CalgaryToSpace/CTS-SAT-2-Optical-Downlink-Module/README.md

# CTS-SAT-2-Optical-Downlink-Module
Repository for optical downlink module hardware and firmware development for the CTS-SAT-2 mission
