CalgaryToSpace/CTS-SAT-2-Optical-Downlink-Module/Transmitter/Hardware/FootprintLibrary/3D Model/MBRS320T3G.stp

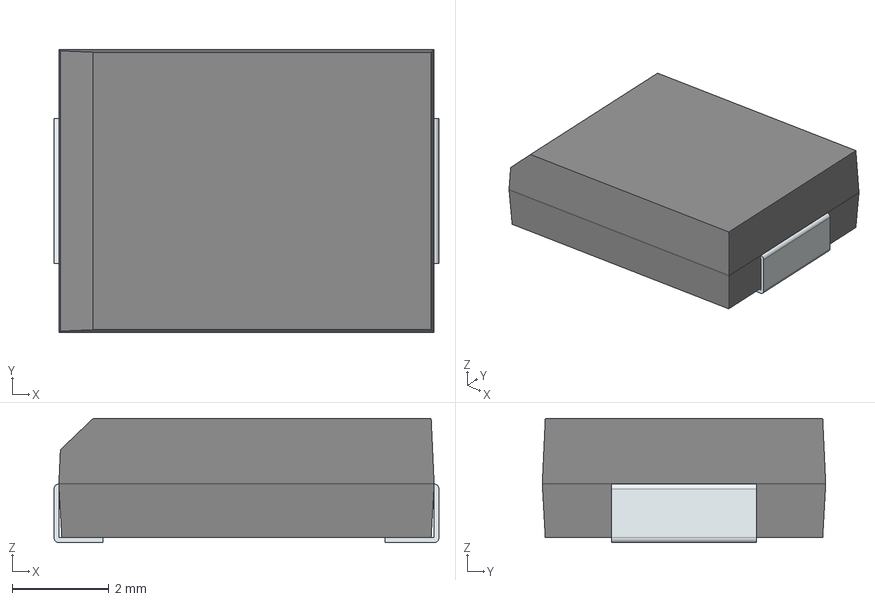
[picture p1: CAD file, 2026-05-02]
Transmitter/Hardware/FootprintLibrary/3D Model/MBRS320T3G.stp
7.94 x 5.84 x 2.56 mm
FilletPin1
FilletPin2
