CalgaryToSpace/CTS-SAT-2-Optical-Downlink-Module/Transmitter/Hardware/FootprintLibrary/3D Model/DR125.step

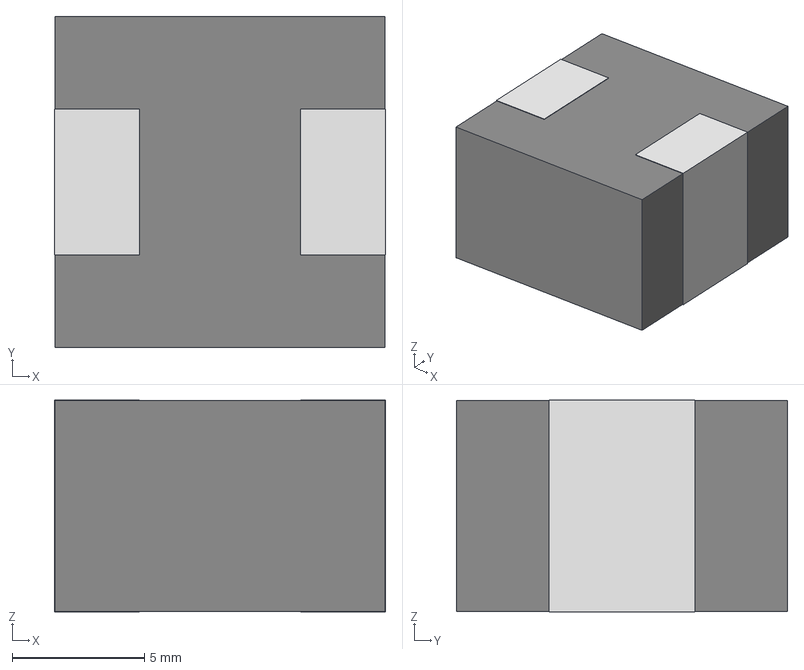
[picture p2: CAD file, 2026-02-14]
Transmitter/Hardware/FootprintLibrary/3D Model/DR125.step
12.5 x 12.5 x 8.00 mm
