CalgaryToSpace/CTS-SAT-2-Optical-Downlink-Module/Transmitter/Hardware/FootprintLibrary/3D Model/OD-624L.stp

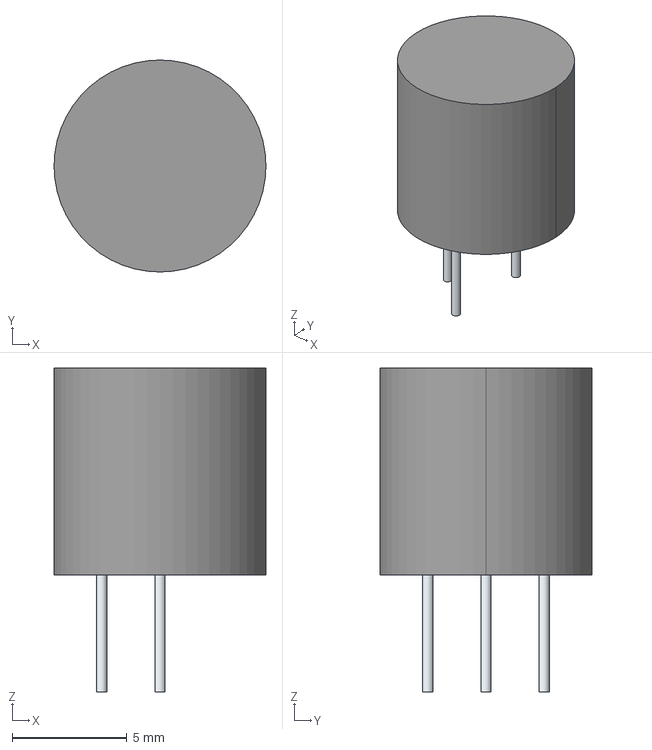
[picture p3: CAD file, 2026-02-11]
Transmitter/Hardware/FootprintLibrary/3D Model/OD-624L.stp
9.25 x 9.25 x 14.1 mm
Leads
