CalgaryToSpace/CTS-SAT-2-Optical-Downlink-Module/Transmitter/Hardware/OpticalDownlinkTransmitter.kicad_pcb

## KiCad design Transmitter/Hardware/OpticalDownlinkTransmitter.kicad_pcb (2026-05-02)

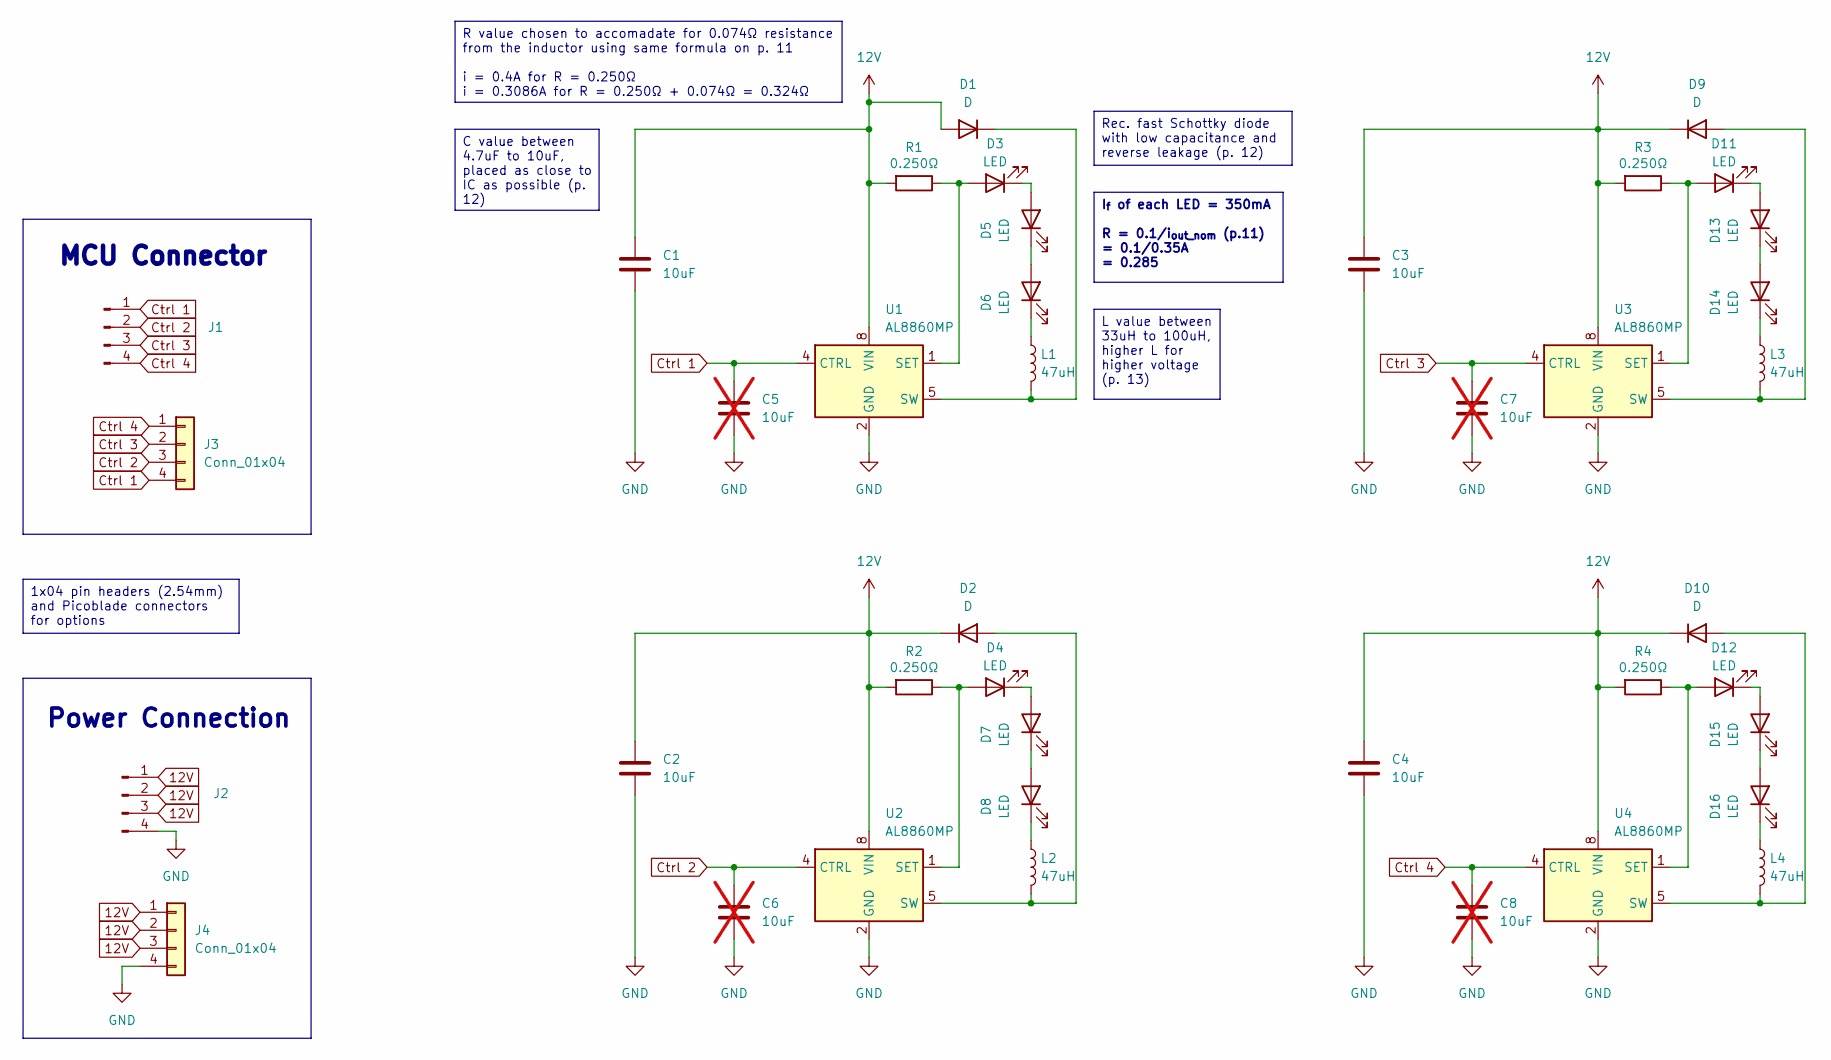
[picture p4: schematic OpticalDownlinkTransmitter.kicad_sch]

Parts:
C1, C2, C3, C4: 10uF; C_0805_2012Metric_Pad1.18x1.45mm_HandSolder; JLCPCB Part C95841
C5, C6, C7, C8: 10uF; C_0805_2012Metric_Pad1.18x1.45mm_HandSolder; JLCPCB Part C95841; not fitted
D1, D2, D9, D10: D; DIOM7958X256N; JLCPCB Part C236151
D3, D4, D5, D6, D7, D8, D11, D12, D13, D14, D15, D16: LED; OD624L; JLCPCB Part C20010764
J1, J2: Conn_01x04_Pin; PinSocket_1x04_P2.54mm_Vertical
J3, J4: Conn_01x04; CONN_532610001-SD_04_MOL
L1, L2, L3, L4: 47uH; DR125; JLCPCB Part C5120951
R1, R3, R4: 0.250Ω; R_2512_6332Metric_Pad1.40x3.35mm_HandSolder; JLCPCB Part C875877
R2: 0.250Ω; R_2512_6332Metric_Pad1.40x3.35mm_HandSolder; Digikey Part RLC73K2AR287FTD
U1, U2, U3, U4: AL8860MP; MSOP-8-1EP_3x3mm_P0.65mm_EP1.5x1.8mm; JLCPCB Part C500782

Connections:
12V: C1.1, C2.1, C3.1, C4.1, D1.2 (A), D2.1 (K), D9.1 (K), D10.1 (K), J2.1, J2.2, J2.3, J4.1, J4.2, J4.3, R1.2, R2.2, R3.2, R4.2, U1.8 (VIN), U2.8 (VIN), U3.8 (VIN), U4.8 (VIN)
Ctrl 1: C5.1, J1.1, J3.4, U1.4 (CTRL)
Ctrl 2: C6.1, J1.2, J3.3, U2.4 (CTRL)
Ctrl 3: C7.1, J1.3, J3.2, U3.4 (CTRL)
Ctrl 4: C8.1, J1.4, J3.1, U4.4 (CTRL)
GND: C1.2, C2.2, C3.2, C4.2, C5.2, C6.2, C7.2, C8.2, J2.4, J4.4, U1.2 (GND), U1.3 (GND), U1.9 (GND), U2.2 (GND), U2.3 (GND), U2.9 (GND), U3.2 (GND), U3.3 (GND), U3.9 (GND), U4.2 (GND), U4.3 (GND), U4.9 (GND)
unnamed: D1.1 (K), L1.2, U1.5 (SW), U1.6 (SW)
unnamed: D2.2 (A), L2.2, U2.5 (SW), U2.6 (SW)
unnamed: D3.2 (A), R1.1, U1.1 (SET)
unnamed: D3.1 (K), D5.2 (A)
unnamed: D4.2 (A), R2.1, U2.1 (SET)
unnamed: D4.1 (K), D7.2 (A)
unnamed: D5.1 (K), D6.2 (A)
unnamed: D6.1 (K), L1.1
unnamed: D7.1 (K), D8.2 (A)
unnamed: D8.1 (K), L2.1
unnamed: D9.2 (A), L3.2, U3.5 (SW), U3.6 (SW)
unnamed: D10.2 (A), L4.2, U4.5 (SW), U4.6 (SW)
unnamed: D11.2 (A), R3.1, U3.1 (SET)
unnamed: D11.1 (K), D13.2 (A)
unnamed: D12.2 (A), R4.1, U4.1 (SET)
unnamed: D12.1 (K), D15.2 (A)
unnamed: D13.1 (K), D14.2 (A)
unnamed: D14.1 (K), L3.1
unnamed: D15.1 (K), D16.2 (A)
unnamed: D16.1 (K), L4.1

Notes on the sheet:
MCU Connector
Power Connection
R value chosen to accomadate for 0.074Ω resistance from the inductor using same formula on p. 11 i = 0.4A for R = 0.250Ω i = 0.3086A for R = 0.250Ω + 0.074Ω = 0.324Ω
1x04 pin headers (2.54mm) and Picoblade connectors for options
I_{f} of each LED = 350mA R = 0.1/i_{out_nom} (p.11) = 0.1/0.35A = 0.285
Rec. fast Schottky diode with low capacitance and reverse leakage (p. 12)
L value between 33uH to 100uH, higher L for higher voltage (p. 13)
C value between 4.7uF to 10uF, placed as close to IC as possible (p. 12)

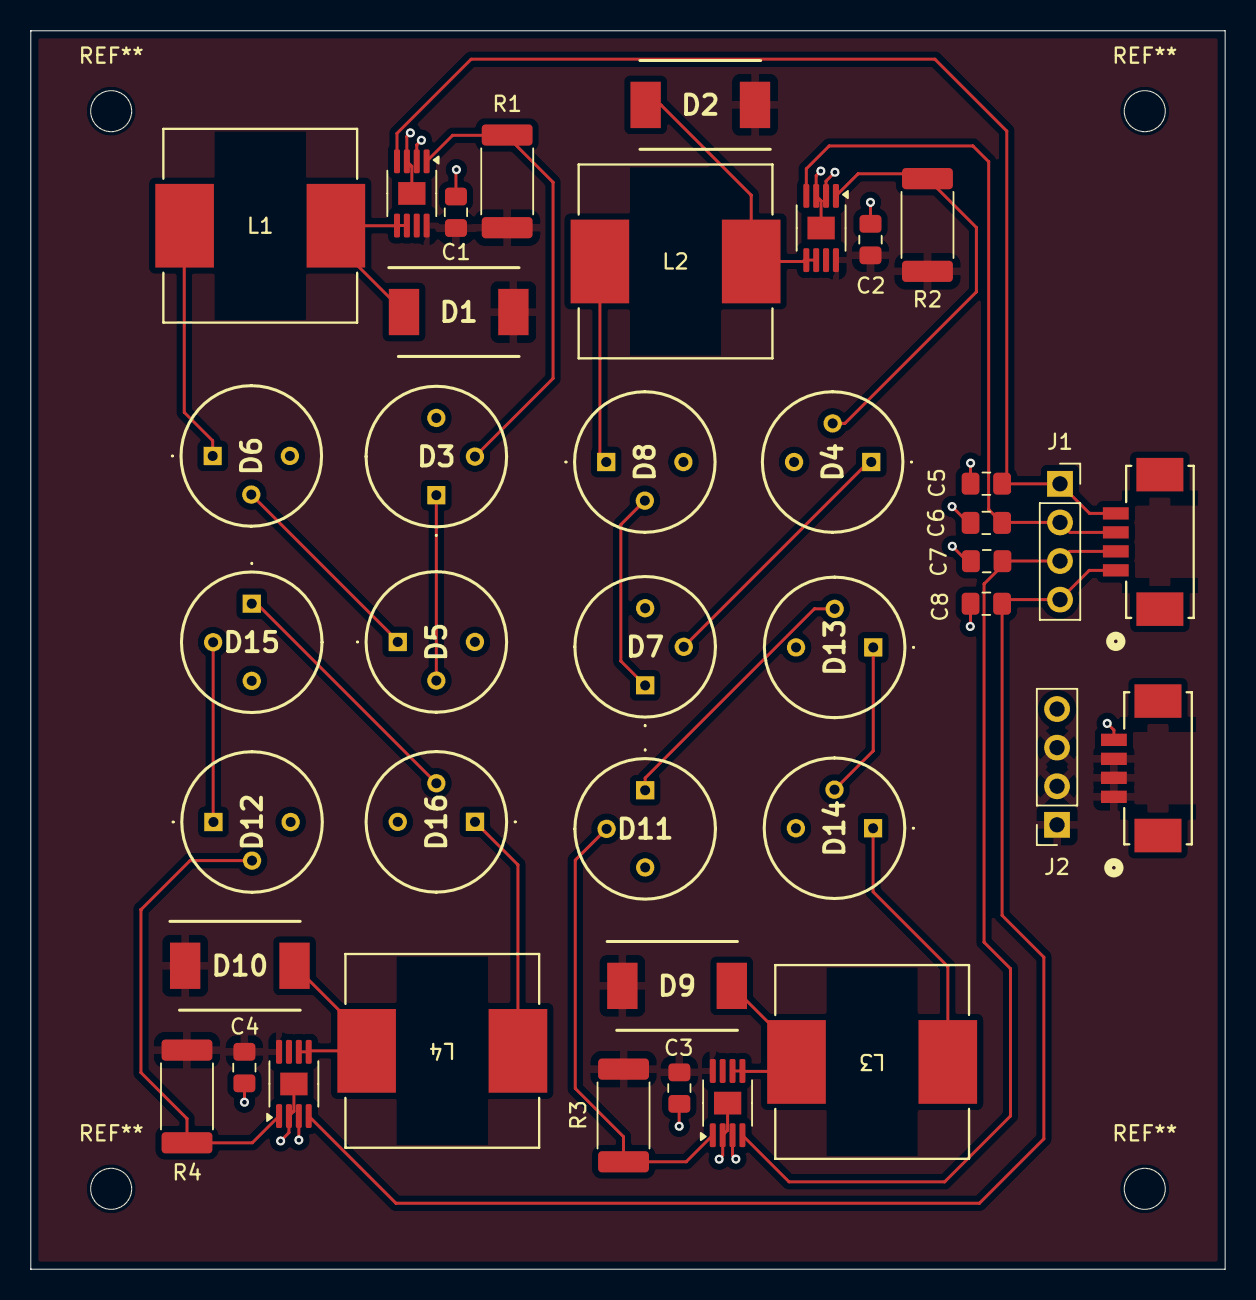
[picture p5: board OpticalDownlinkTransmitter.kicad_pcb from above]

Board: 2 copper layers, 78.6 x 81.5 mm, 40 parts (0 on the bottom side), 26 nets.
