CalgaryToSpace/CTS-SAT-2-Optical-Downlink-Module/Receiver/Hardware/Optical Downlink Kicad Project.kicad_pcb

## KiCad design Receiver/Hardware/Optical Downlink Kicad Project.kicad_pcb (2026-02-25)

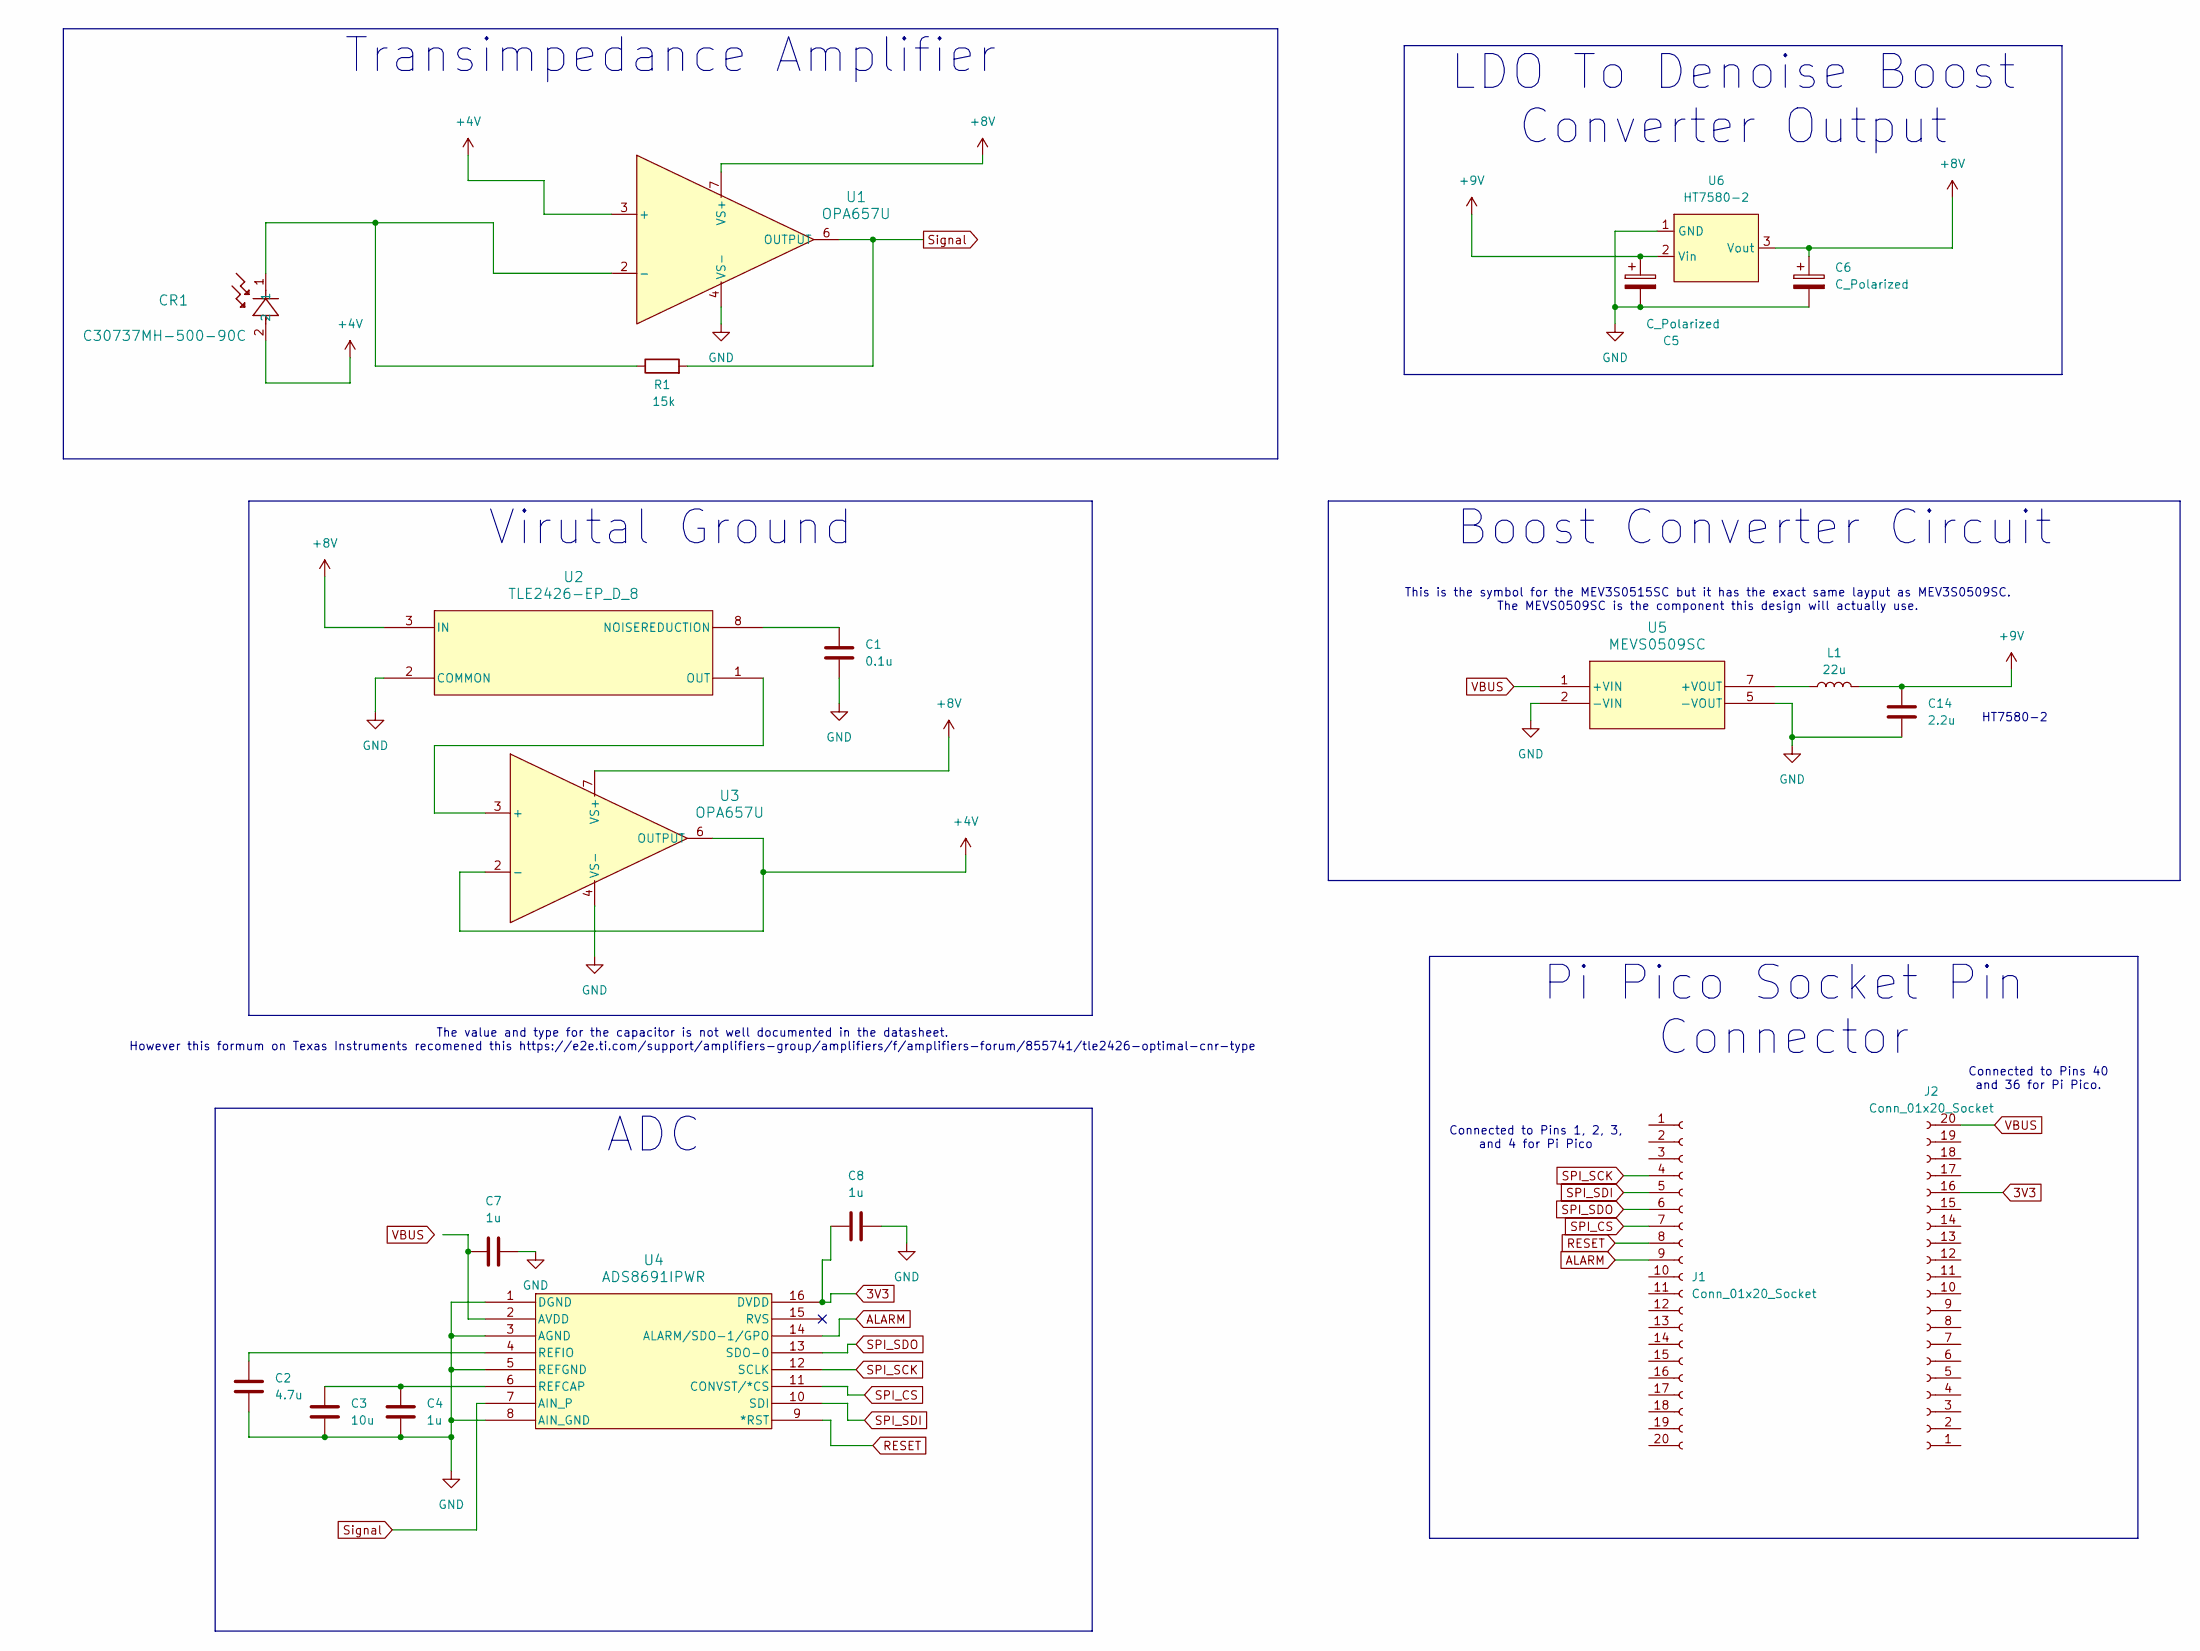
[picture p6: schematic Optical Downlink Kicad Project.kicad_sch]

Parts:
C1: 0.1u; CAPC1005X55N
C2: 4.7u; C_0603_1608Metric
C3: 10u; C_0402_1005Metric
C4, C7, C8: 1u; CAP_CL10_SAM
C5, C6: C_Polarized; CAPMP6.3X3.2_2.8N_KEM
C14: 2.2u; C_0603_1608Metric
CR1: C30737MH-500-90C; FR4_C30737MH_EXT
J1, J2: Conn_01x20_Socket; PinHeader_1x20_P2.54mm_Vertical
L1: 22u; IND_8400_84XXXC_MUR
R1: 15k; RC0402N_YAG
U1, U3: OPA657U; OPA 657 D8
U2: TLE2426-EP_D_8; D8_TEX TLE2426-EP_D_8
U4: ADS8691IPWR; ADS8691IPWR_TEX
U5: MEVS0509SC; DC_MEV3_7P65X19P65_MUR
U6: HT7580-2; SOT-23-5

Connections:
3V3: C8.1, J2.16, U4.16 (DVDD)
+4V: CR1.2, U1.3 (+), U3.2 (-), U3.6 (OUTPUT)
+8V: C6.1, U1.7 (VS+), U2.3 (IN), U3.7 (VS+), U6.3 (Vout)
+9V: C5.1, C14.1, L1.2, U6.2 (Vin)
ALARM: J1.9, U4.14 (ALARM/SDO-1/GPO)
GND: C1.2, C2.2, C3.2, C4.2, C5.2, C6.2, C7.2, C8.2, C14.2, U1.4 (VS-), U2.2 (COMMON), U3.4 (VS-), U4.1 (DGND), U4.3 (AGND), U4.5 (REFGND), U4.8 (AIN_GND), U5.2 (-VIN), U5.5 (-VOUT), U6.1 (GND)
unnamed: CR1.1, R1.1, U1.2 (-)
unnamed: C1.1, U2.8 (NOISEREDUCTION)
unnamed: U2.1 (OUT), U3.3 (+)
unnamed: C7.1, U4.2 (AVDD)
unnamed: C3.1, C4.1, U4.6 (REFCAP)
unnamed: C2.1, U4.4 (REFIO)
unnamed: L1.1, U5.7 (+VOUT)
RESET: J1.8, U4.9 (*RST)
SPI_CS: J1.7, U4.11 (CONVST/*CS)
SPI_SCK: J1.4, U4.12 (SCLK)
SPI_SDI: J1.5, U4.10 (SDI)
SPI_SDO: J1.6, U4.13 (SDO-0)
Signal: R1.2, U1.6 (OUTPUT), U4.7 (AIN_P)
VBUS: J2.20, U5.1 (+VIN)

Notes on the sheet:
Connected to Pins 1, 2, 3, and 4 for Pi Pico
The value and type for the capacitor is not well documented in the datasheet. However this formum on Texas Instruments recomened this https://e2e.ti.com/support/amplifiers-group/amplifiers/f/amplifiers-forum/855741/tle2426-optimal-cnr-type
Connected to Pins 40 and 36 for Pi Pico.
HT7580-2
This is the symbol for the MEV3S0515SC but it has the exact same layput as MEV3S0509SC. The MEVS0509SC is the component this design will actually use.
LDO To Denoise Boost Converter Output
Boost Converter Circuit
Pi Pico Socket Pin Connector
Virutal Ground
Transimpedance Amplifier
ADC

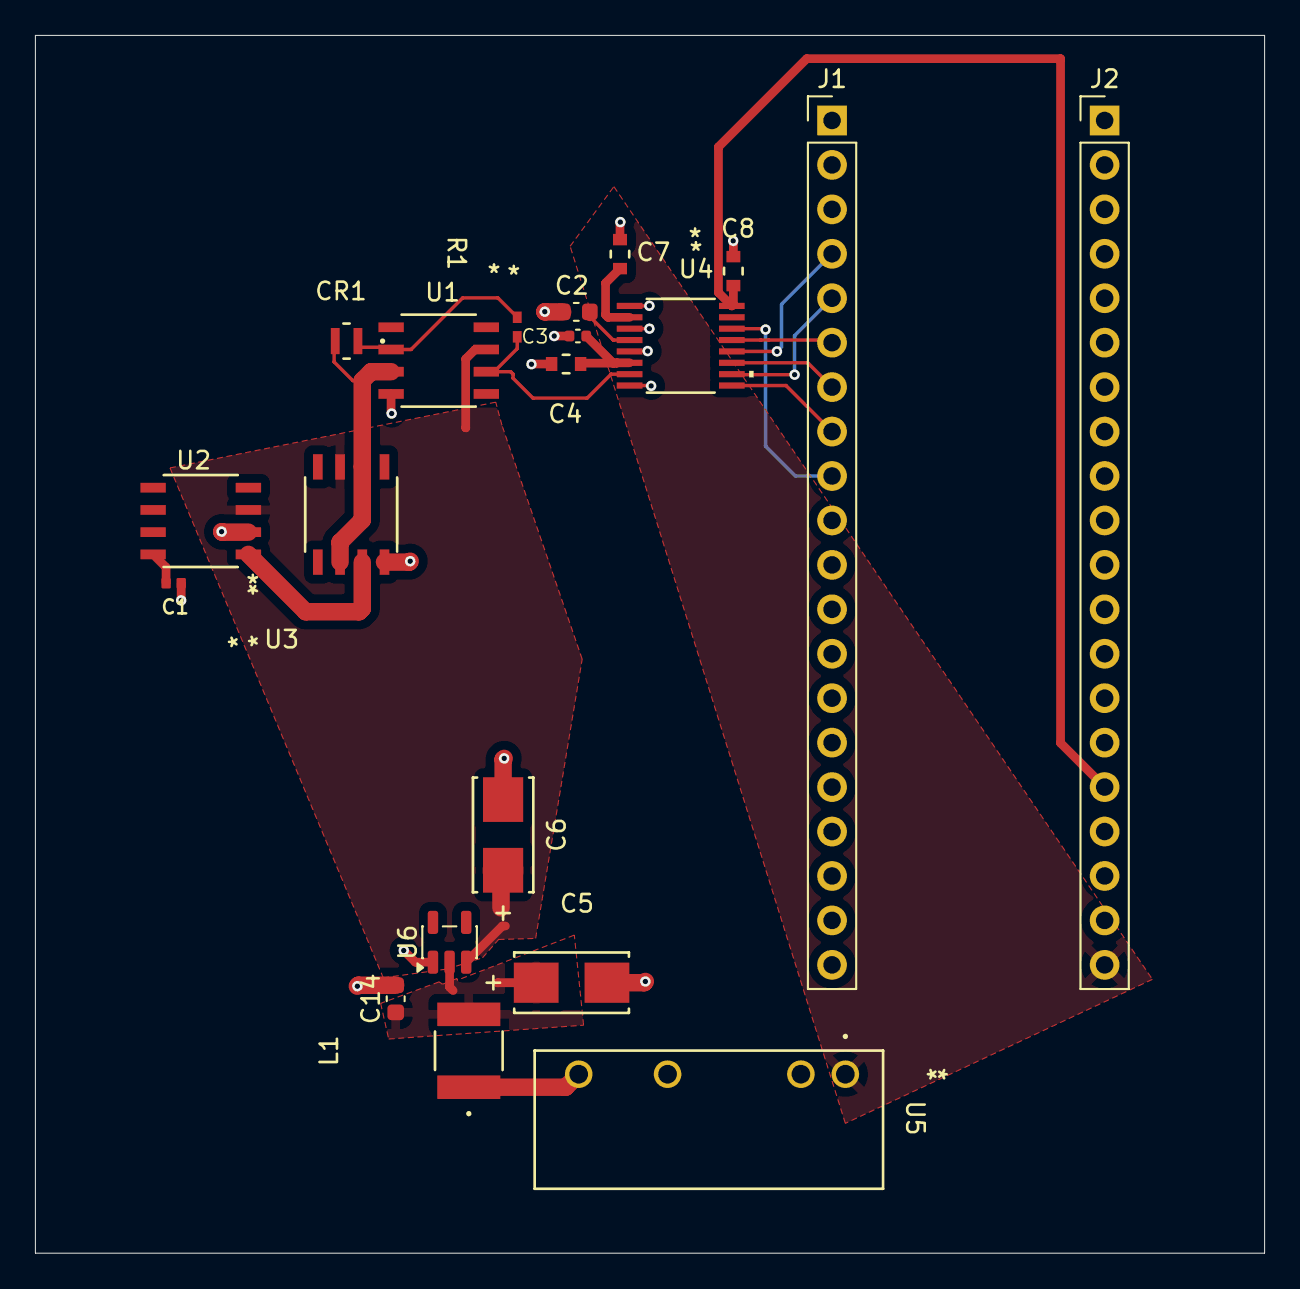
[picture p7: board Optical Downlink Kicad Project.kicad_pcb from above]

Board: 2 copper layers, 70.2 x 69.6 mm, 20 parts (0 on the bottom side), 20 nets.
