CalgaryToSpace/CTS-SAT-2-Optical-Downlink-Module/(commit log)

2025-12-06 Initial Commit
    Created hardware project files for receiver side systems on optical downlink module.
    [Optical Downlink Kicad Project.kicad_pcb, Optical Downlink Kicad Project.kicad_sch]
2025-12-06 Test Commit
    [Optical Downlink Kicad Project.kicad_sch]
2026-01-10 Fixed issues with signal and power flags in Schematic
    Fixed a issue with the signal not being wired to ADC properly, also fixed a issue where multiple flags were used for the digital power.
    [Optical Downlink Kicad Project.kicad_sch]
2026-01-10 Created Transmitter Kicad project
    [OpticalDownlinkTransmitter.kicad_pcb, OpticalDownlinkTransmitter.kicad_sch]
2026-01-10 Added some symbols to the library.
    [Optical Downlink Kicad Project.kicad_sch]
2026-01-17 Changed LDO and Boost Converter
    The Max743 was switched out for the MEV3S0509SC so that it the 5V is converted to 9V instead of 12V by the DC-DC converter. The TPS7A4700 was replaced with the LM2940IMPX-8.0/NOPB so that 9V could be brought down to 8V instead of 12V could be brought down to 11V.
    [Optical Downlink Kicad Project.kicad_sch]
2026-01-17 Cleaned up Schematic and began placing Footprints
    [Optical Downlink Kicad Project.kicad_pcb, Optical Downlink Kicad Project.kicad_sch]
2026-01-21 Made some Symbol Changes
    Have to change LDO and Boost Converter to components more accessible on JLC PCB.
    [Optical Downlink Kicad Project.kicad_pcb, Optical Downlink Kicad Project.kicad_sch]
2026-01-28 Initial Transmitter Schematic
    Copy and pasted from external file.
    [OpticalDownlinkTransmitter.kicad_sch]
2026-01-28 Created a Project Library
    Includes the OD-624L LED
2026-01-28 Created Footprint Library
    Included OD624L LED Footprint
2026-01-28 Assigned a couple footprints
    [OpticalDownlinkTransmitter.kicad_pcb, OpticalDownlinkTransmitter.kicad_sch]
2026-01-28 Worked on the layout of Optical Downlink
    Fixed the layout also added in packages for LDO and boost converter. Need to fix net problems in kicad.
    [Optical Downlink Kicad Project.kicad_pcb, Optical Downlink Kicad Project.kicad_sch]
2026-01-31 Began PCB layout
    Also fixed some schematic issues.
    [Optical Downlink Kicad Project.kicad_sch]
2026-02-04 Assigned a couple footprints and started adding JLBPCB Parts
    [OpticalDownlinkTransmitter.kicad_sch]
2026-02-04 Worked on Assigning capacitor and resistors components
    Specifically feedback resistor and worked on capacitor in virtual ground circuit.
    [Optical Downlink Kicad Project.kicad_pcb, Optical Downlink Kicad Project.kicad_sch]
2026-02-05 Worked on Assigning Cap and R footprints
    Also fixed an issue with some missing capacitors
    [Optical Downlink Kicad Project.kicad_pcb, Optical Downlink Kicad Project.kicad_sch]
2026-02-06 Finished General Layout of PCB
    Everything is pretty much finished for traces except gnd connections and clearing drc errors.
    [Optical Downlink Kicad Project.kicad_pcb, Optical Downlink Kicad Project.kicad_sch]
2026-02-06 Fixed Issues with DRC ready to be checked
    [Optical Downlink Kicad Project.kicad_pcb]
2026-02-11 Assigned JLCPCB Parts and footprints
    Inductor is the remaining component left to find
    [OD-624L.stp, OpticalDownlinkTransmitter.kicad_sch]
2026-02-14 Assigned JLCPCB Parts
    [OpticalDownlinkTransmitter.kicad_sch]
2026-02-14 Fixed schematic layout
    [DR125.step, OpticalDownlinkTransmitter.kicad_sch]
2026-02-15 Cleaned Up Some of The Power Net Names
    [Optical Downlink Kicad Project.kicad_pcb, Optical Downlink Kicad Project.kicad_sch]
2026-02-21 Cleaned up Schematic a bit
    [Optical Downlink Kicad Project.kicad_sch]
2026-02-25 Added capacitors and fixed values in schematic
    [DR125.step, OD-624L.stp, OpticalDownlinkTransmitter.kicad_pcb, OpticalDownlinkTransmitter.kicad_sch]
2026-02-28 Added extra connectors and changed resistor
    [OpticalDownlinkTransmitter.kicad_sch]
2026-03-07 added footprints and redid layout
    [OpticalDownlinkTransmitter.kicad_pcb, OpticalDownlinkTransmitter.kicad_sch]
2026-03-15 Adjusted layout so tracing would be easier
    [OpticalDownlinkTransmitter.kicad_pcb, OpticalDownlinkTransmitter.kicad_sch]
2026-03-29 traced almost all of the components together and added mounting holes
    [MBRS320T3G.stp, OpticalDownlinkTransmitter.kicad_pcb]
2026-04-08 completed tracing and changed polygon clearance and fixed up math in schematic
    [OpticalDownlinkTransmitter.kicad_pcb, OpticalDownlinkTransmitter.kicad_sch]
2026-05-02 Simulation added for proper redesign of reciever
    [Optical Downlink Kicad Project.kicad_sch]
